KamoNanban/Manta60/Layout/Manta60BLE/Manta60-BLE_MidPlate_Hole_v01.pdf

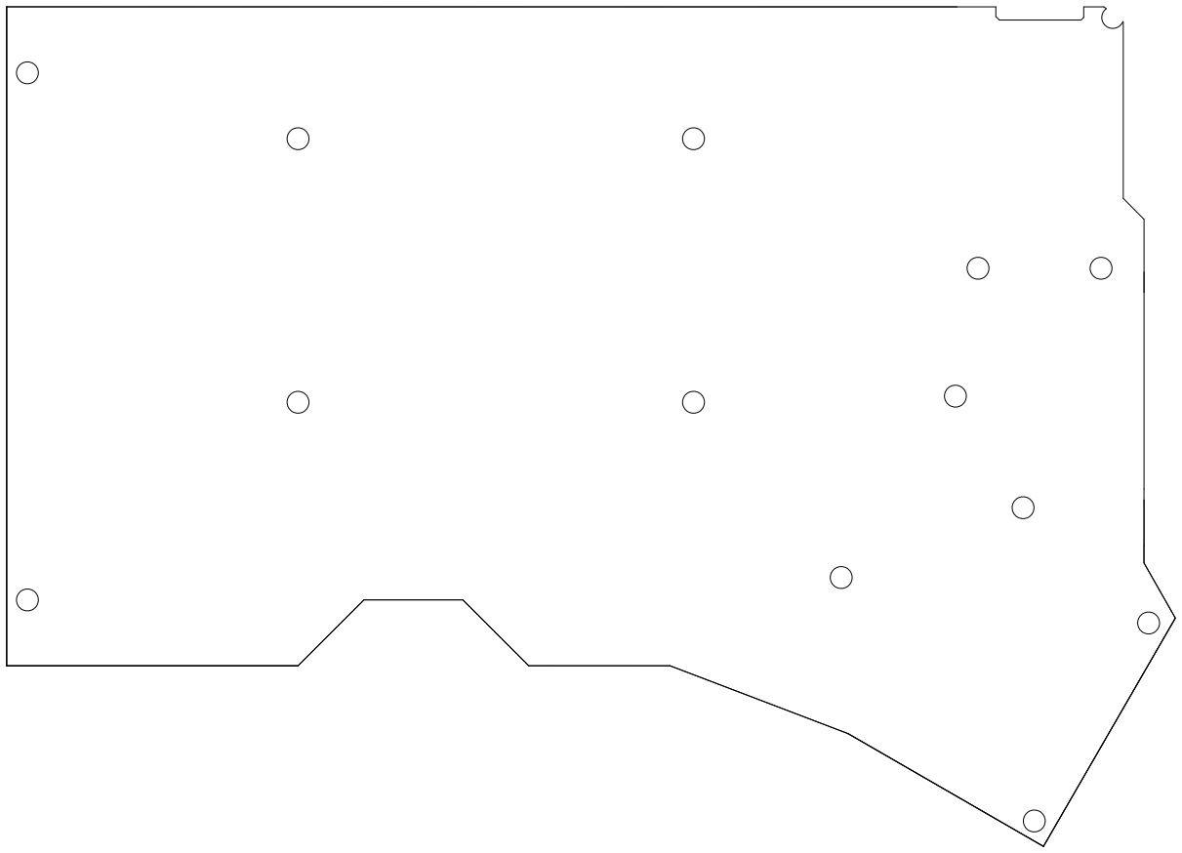
[picture p16: figure]
