KamoNanban/Manta60/documents/_image/IMG_20191230_221700.jpg

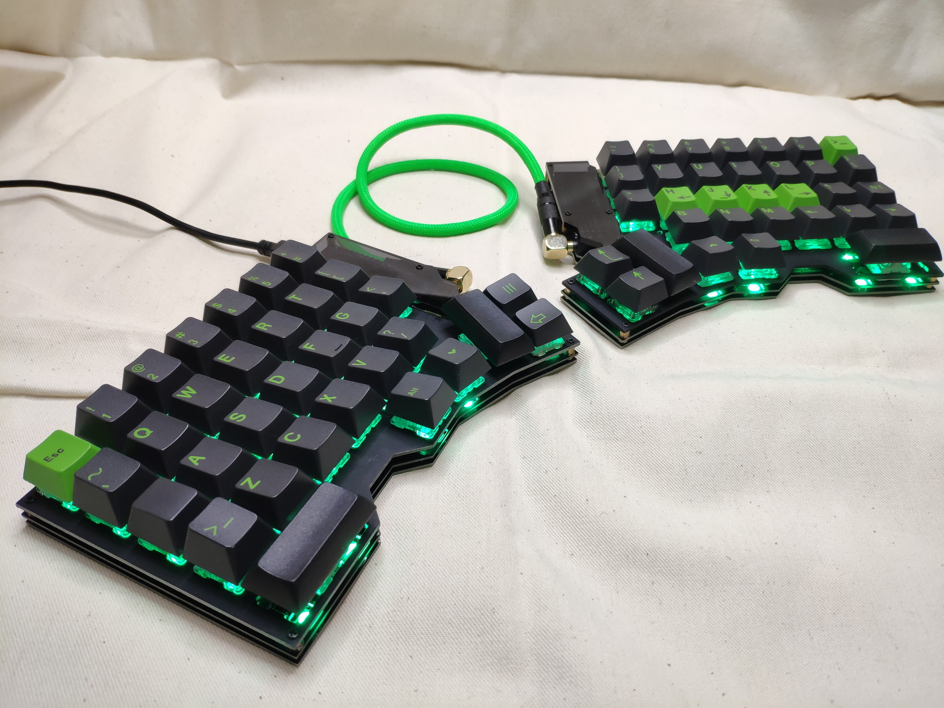
documents/_image/IMG_20191230_221700.jpg
