KamoNanban/Manta60/documents/_image/manta60.jpg

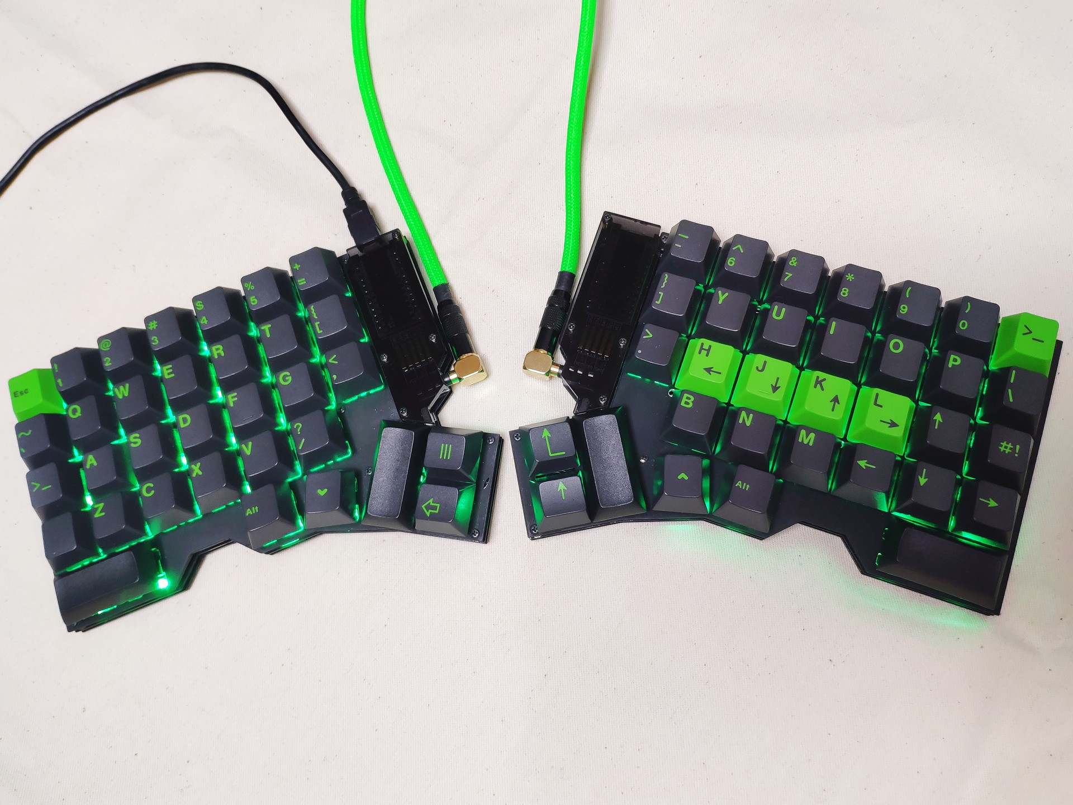
documents/_image/manta60.jpg
