KamoNanban/Manta60/documents/_image/manta60_1.jpg

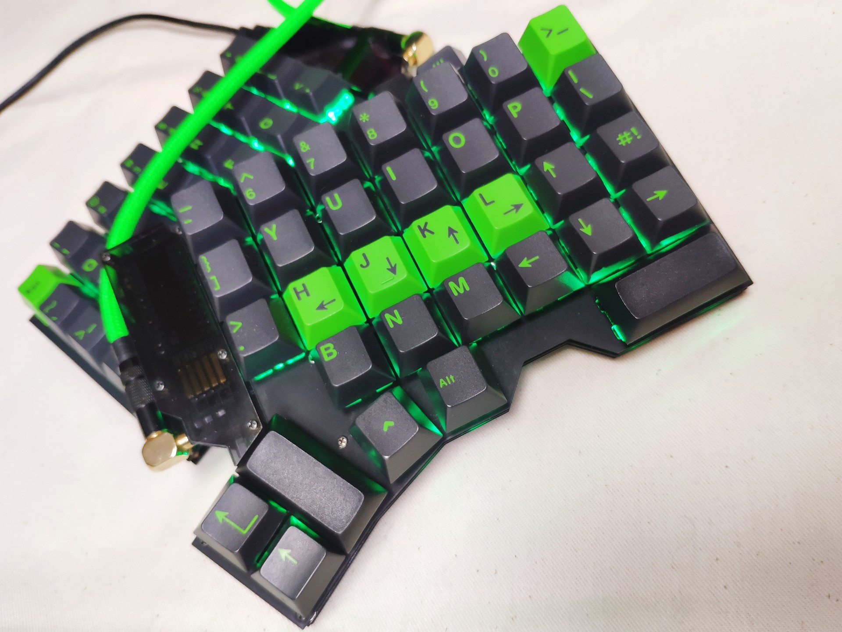
documents/_image/manta60_1.jpg
