KamoNanban/Manta60/BottomPlate/Manta60BLE_Bottom.DXF

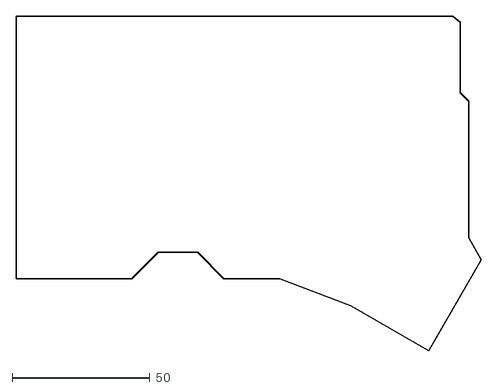
[picture p20: CAD file, 2019-01-26]
BottomPlate/Manta60BLE_Bottom.DXF
168.9 x 121.4
