KamoNanban/Manta60/Layout/Manta60BLE/Manta60BLE_BottomPlate.DXF

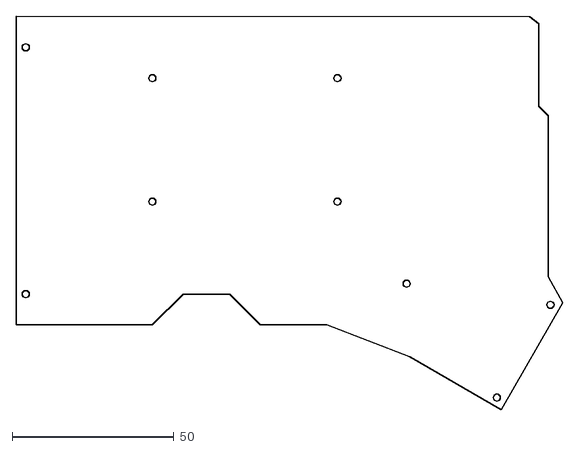
[picture p21: CAD file, 2019-01-29]
Layout/Manta60BLE/Manta60BLE_BottomPlate.DXF
168.9 x 121.4
