KamoNanban/Manta60/Layout/Manta60BLE/Manta60-BLE_PartsLayout_v01.pdf

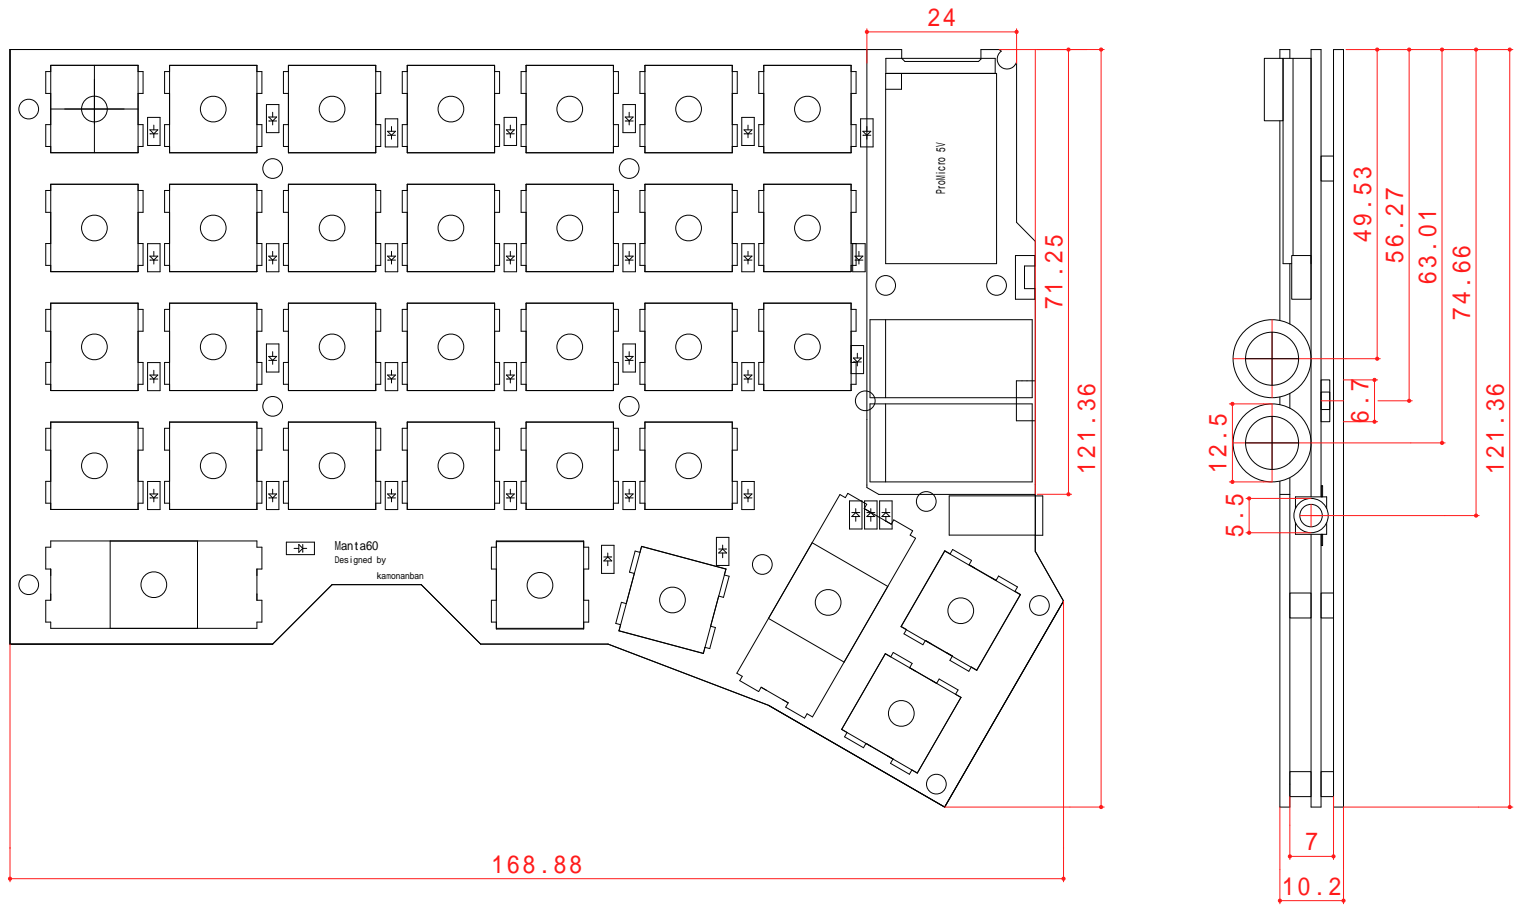
[picture p23: page 1]
