KamoNanban/Manta60/Layout/Manta60BLE/Manta60BLE_BottomPlate.pdf

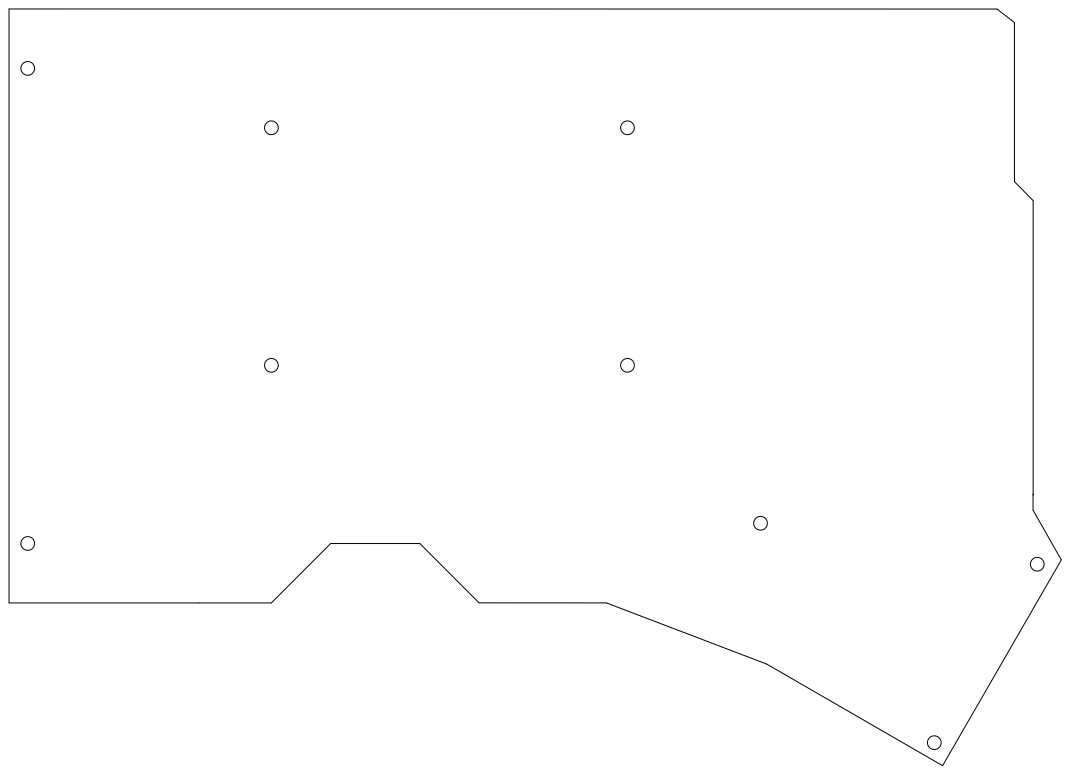
[picture p24: page 1]
