KamoNanban/Manta60/Layout/Manta60BLE/Manta60BLE_TopPlate.pdf

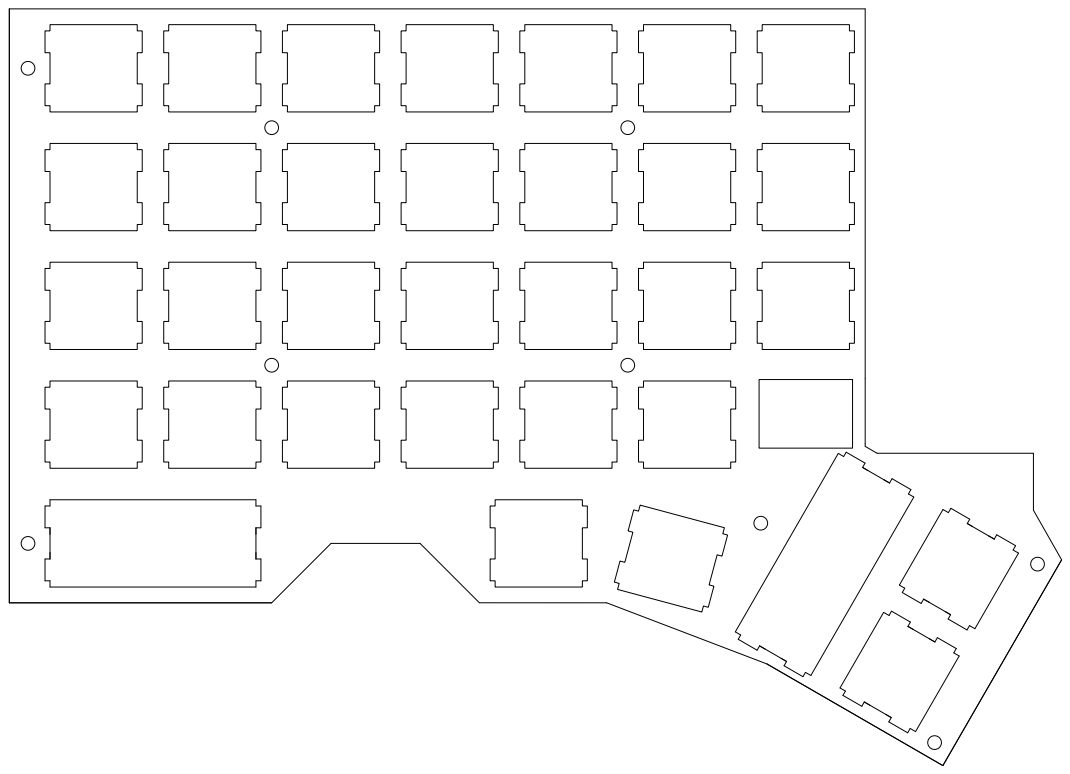
[picture p25: page 1]
