KamoNanban/Manta60/MidPlate/Manta60_Mid_Right.kicad_pcb

## KiCad design MidPlate/Manta60_Mid_Right.kicad_pcb (2019-04-11)

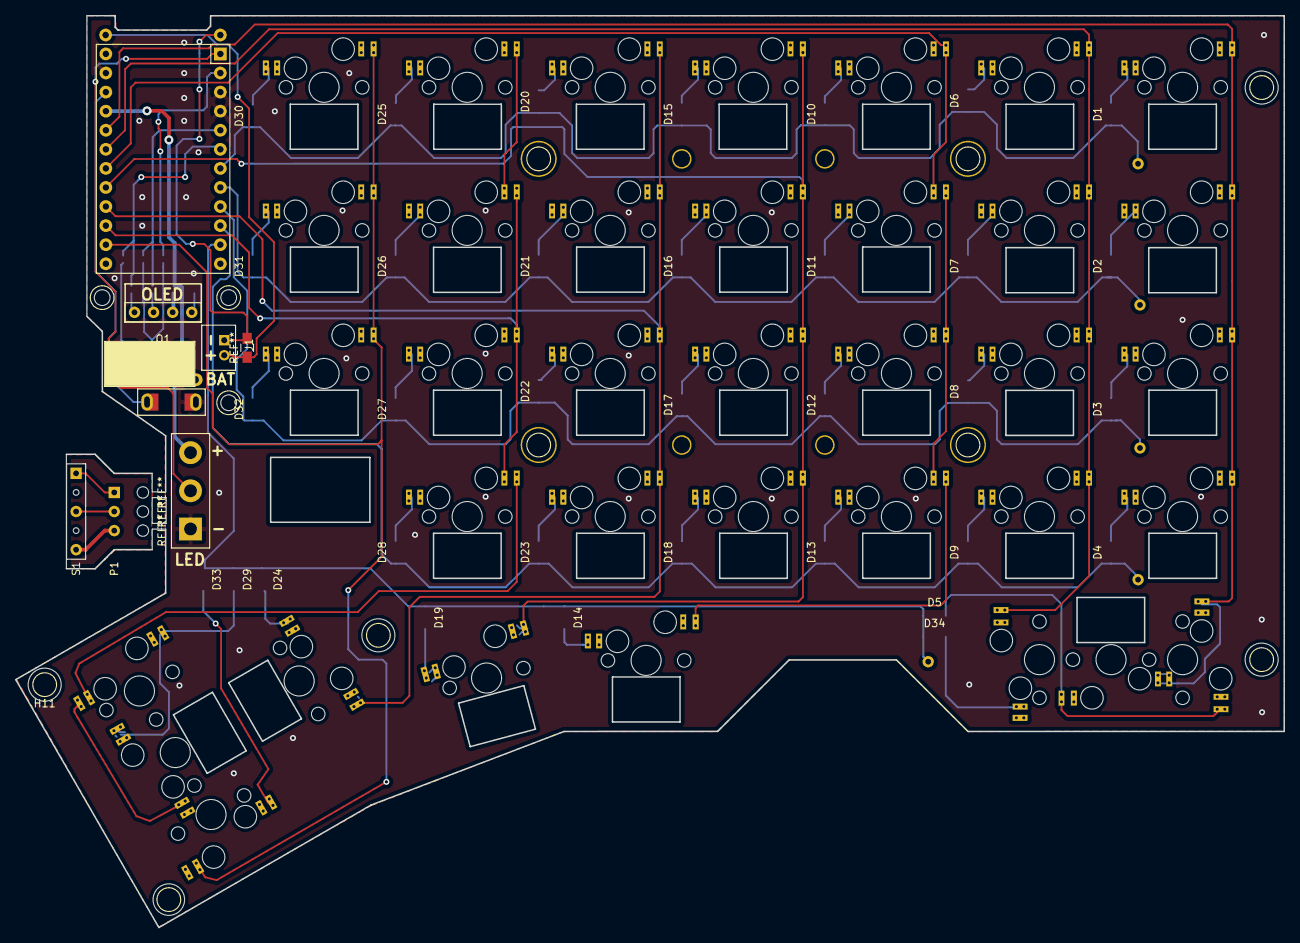
[picture p26: board Manta60_Mid_Right.kicad_pcb from above]

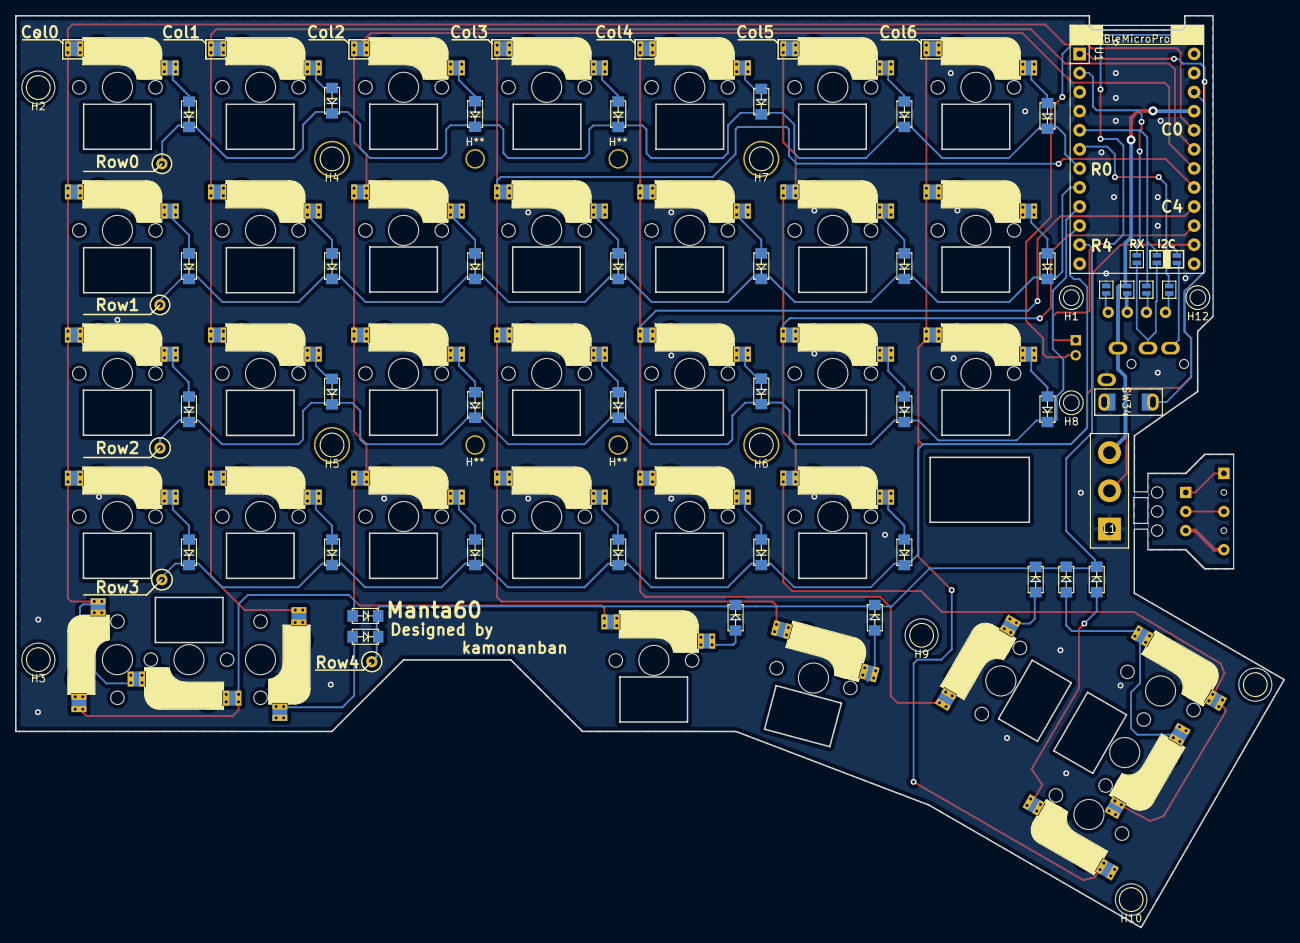
[picture p27: board Manta60_Mid_Right.kicad_pcb from below]

Board: 2 copper layers, 168.9 x 121.4 mm, 101 parts (25 on the bottom side), 64 nets.

Parts:
D1, D2, D3, D4, D5, D6, D7, D8, D9, D10, D11, D12, D13, D14, D15, D16, D17, D18, D19, D20, D21, D22, D23, D24, D25, D26, D27, D28, D29, D30, D31, D32, D33, D34: D; 1N4148_v01
H1, H2, H3, H9, H10, H11, H12: HOLE; M3
H4, H5, H6, H7: HOLE; M2_SP
H8: M3
H**: HOLE
H**#2, H**#3, H**#4: HOLE
J1: Conn_01x02; PH_2Pin_Top
JP1, JP2, JP3, JP4, JP5, JP6, JP7: Jumper3
L1: LED; LED-PIN
O1: OLED
P1: LED-pin; Led-pin
S1: LED-socket
SW1, SW2, SW3, SW4, SW6, SW7, SW8, SW9, SW10, SW11, SW12, SW13, SW14, SW15, SW16, SW17, SW18, SW19, SW20, SW21, SW22, SW23, SW24, SW25, SW26, SW27, SW28, SW30, SW31, SW32, SW33, SW35: SW_Push; CherryMX_Hotswap_right
SW5, SW5#2, SW29, SW29#2: SW_Push; CherryMX_Hotswap_left
SW34: Reset_SW; RST_SW
T1: TRRS; MJ-4PP-9_rev1
U1: ProMicro

Connections:
BAT: J1.1, U1.25
BAT_GND: J1.2, U1.26
Col0: SW1.1, SW2.1, SW3.1, SW4.1, SW5.1, SW5#2.1, U1.20
Col1: SW6.1, SW7.1, SW8.1, SW9.1, SW35.1, U1.19
Col2: SW10.1, SW11.1, SW12.1, SW13.1, SW14.1, U1.18
Col3: SW15.1, SW16.1, SW17.1, SW18.1, SW19.1, U1.17
Col4: SW20.1, SW21.1, SW22.1, SW23.1, SW24.1, U1.16
Col5: SW25.1, SW26.1, SW27.1, SW28.1, SW29.1, SW29#2.1, U1.15
Col6: SW30.1, SW31.1, SW32.1, SW33.1, U1.14
Data: JP7.2, U1.2
GND: JP1.2, L1.3, SW34.2, T1.A, U1.3, U1.4, U1.23
LED: L1.2, U1.1
unnamed: D1.2, SW1.2
unnamed: D2.2, SW2.2
unnamed: D3.2, SW3.2
unnamed: D4.2, SW4.2
unnamed: D5.2, SW5.2, SW5#2.2
unnamed: D6.2, SW6.2
unnamed: D7.2, SW7.2
unnamed: D8.2, SW8.2
unnamed: D9.2, SW9.2
unnamed: D10.2, SW10.2
unnamed: D11.2, SW11.2
unnamed: D12.2, SW12.2
unnamed: D13.2, SW13.2
unnamed: D14.2, SW14.2
unnamed: D15.2, SW15.2
unnamed: D16.2, SW16.2
unnamed: D17.2, SW17.2
unnamed: D18.2, SW18.2
unnamed: D19.2, SW19.2
unnamed: D20.2, SW20.2
unnamed: D21.2, SW21.2
unnamed: D22.2, SW22.2
unnamed: D23.2, SW23.2
unnamed: D24.2, SW24.2
unnamed: D25.2, SW25.2
unnamed: D26.2, SW26.2
unnamed: D27.2, SW27.2
unnamed: D28.2, SW28.2
unnamed: D29.2, SW29.2, SW29#2.2
unnamed: D30.2, SW30.2
unnamed: D31.2, SW31.2
unnamed: D32.2, SW32.2
unnamed: D33.2, SW33.2
unnamed: D34.2, SW35.2
unnamed: JP1.1, O1.1
unnamed: JP2.1, O1.2
unnamed: JP3.1, O1.3
unnamed: JP4.1, O1.4
unnamed: JP5.1, JP7.1, T1.C
unnamed: JP6.1, T1.B
unnamed: P1.1, S1.1
unnamed: P1.2, S1.2
unnamed: P1.3, S1.3
RST: SW34.1, U1.22
Row0: D1.1, D6.1, D10.1, D15.1, D20.1, D25.1, D30.1, U1.7
Row1: D2.1, D7.1, D11.1, D16.1, D21.1, D26.1, D31.1, U1.8
Row2: D3.1, D8.1, D12.1, D17.1, D22.1, D27.1, D32.1, U1.9
Row3: D4.1, D9.1, D13.1, D18.1, D23.1, D28.1, U1.10
Row4: D5.1, D14.1, D19.1, D24.1, D29.1, D33.1, D34.1, U1.11
SCL: JP3.2, JP5.2, U1.5
SDA: JP4.2, JP6.2, U1.6
VCC: JP2.2, L1.1, T1.D, U1.21
