KamoNanban/Manta60/(commit log)

2019-01-26 rev0.1
    My first commit
    [Manta60BLE_Bottom-B.Cu.gbr, Manta60BLE_Bottom-B.Mask.gbr, Manta60BLE_Bottom-B.SilkS.gbr, Manta60BLE_Bottom-Edge.Cuts.gbr, Manta60BLE_Bottom-F.Cu.gbr, Manta60BLE_Bottom-F.Mask.gbr, Manta60BLE_Bottom-F.SilkS.gbr, Manta60BLE_Bottom-NPTH.drl]
2019-01-29 LayoutUp
    LayoutUPdate
    [Manta60BLE_BottomPlate.DXF, Manta60BLE_TopPlate.DXF]
